ECE3SAT/ECE3SAT_ADCS/PhaseB/Simulator/Simulation/img/Earth.JPG5a55ca7f-1d7c-41d7-b161-80501e00d095Larger.jpg

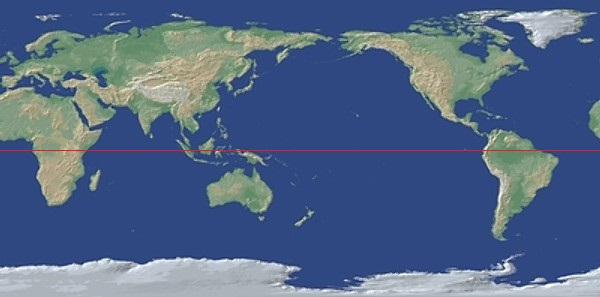
PhaseB/Simulator/Simulation/img/Earth.JPG5a55ca7f-1d7c-41d7-b161-80501e00d095Larger.jpg
