ECE3SAT/ECE3SAT_ADCS/PhaseB/Simulator/Simulation/img/main_900.jpg

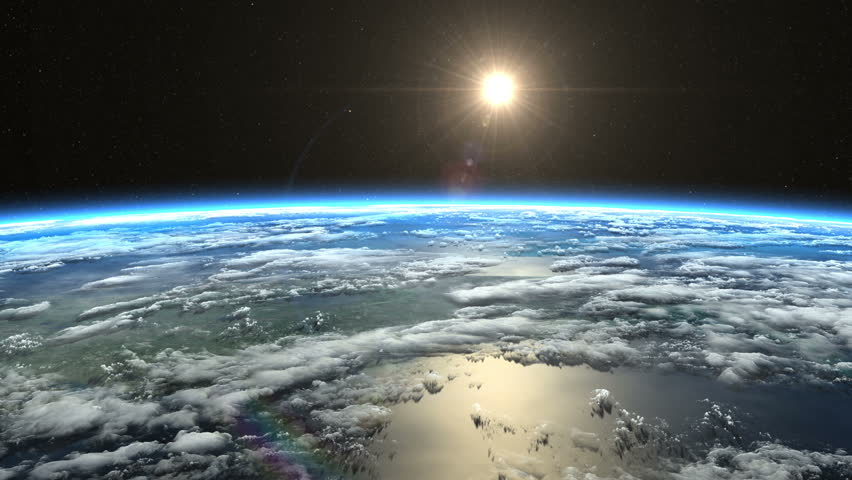
PhaseB/Simulator/Simulation/img/main_900.jpg
