ECE3SAT/ECE3SAT_ADCS/PhaseA/Simulation/SimulationWithBoard/ProcessingCode/Euler/Orientation_Sensors_Reading/solar_panel.png

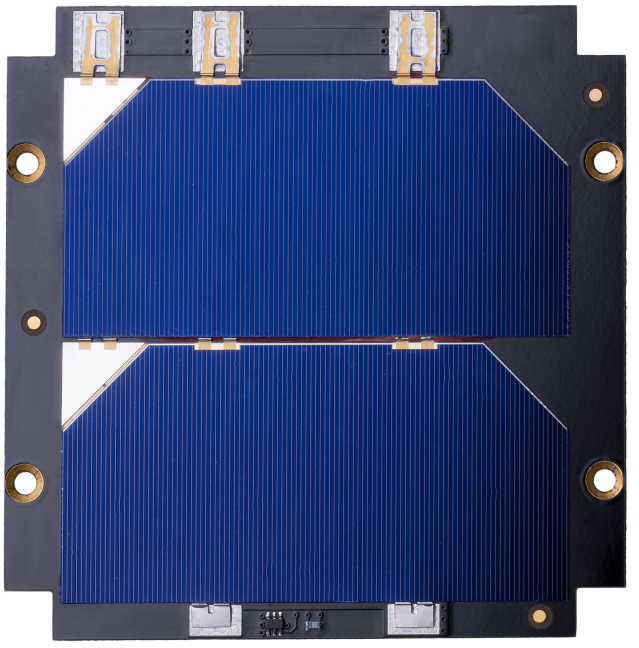
PhaseA/Simulation/SimulationWithBoard/ProcessingCode/Euler/Orientation_Sensors_Reading/solar_panel.png
