ECE3SAT/ECE3SAT_ADCS/PhaseB/Helmholtz coils - CubeSat/Cube/Cube.SLDASM

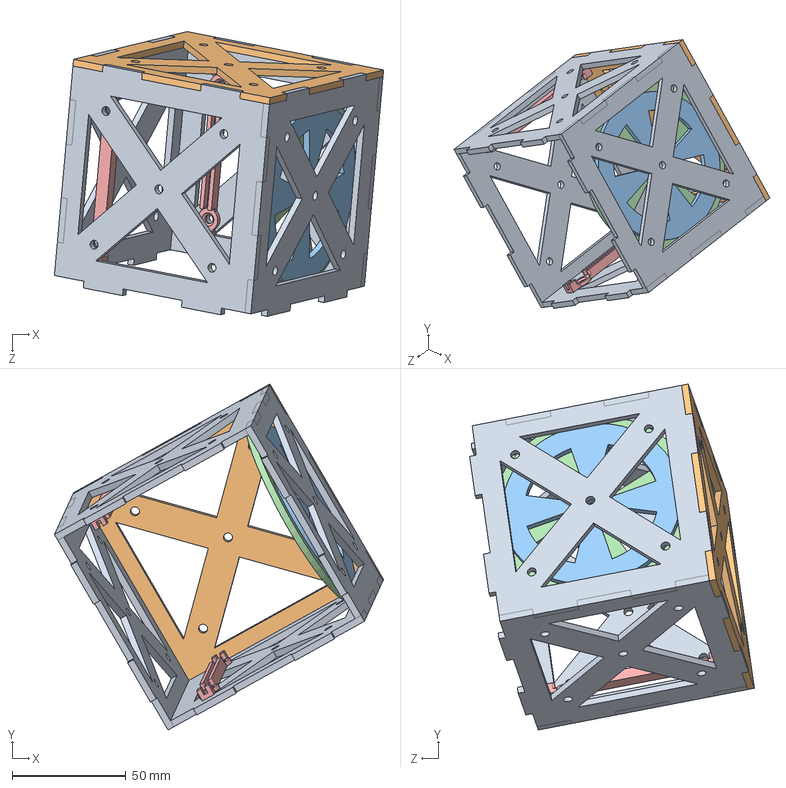
[picture p6: CAD file, 2018-02-19]
PhaseB/Helmholtz coils - CubeSat/Cube/Cube.SLDASM
144.5 x 151.9 x 125.0 mm
CubeSide x 4
wheelXS
wheelS
Rail x 2
