ECE3SAT/ECE3SAT_ADCS/PhaseB/Helmholtz coils - CubeSat/Gyro/Gyro.SLDASM

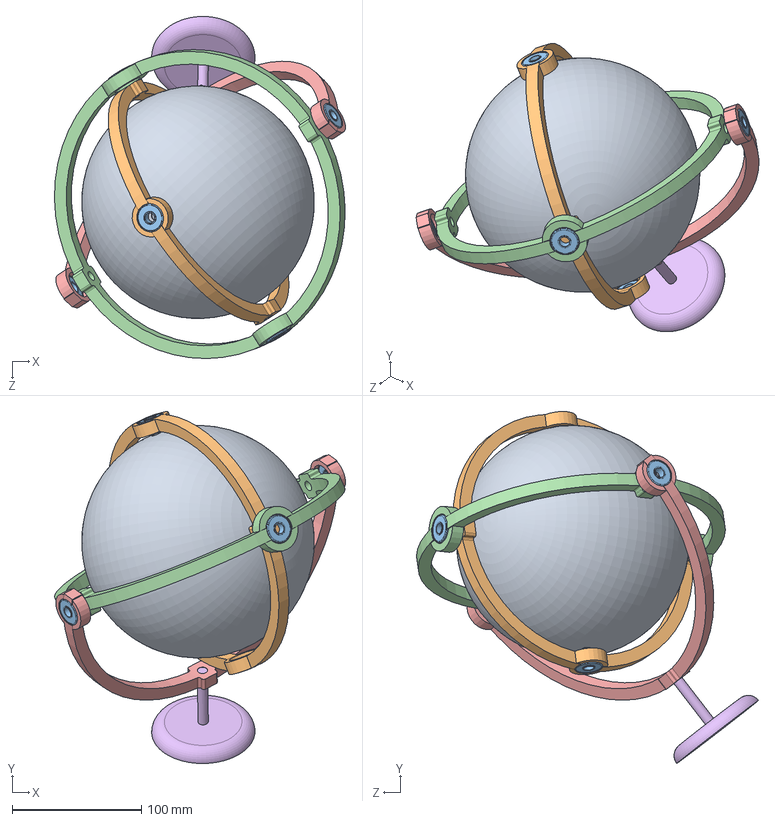
[picture p7: CAD file, 2018-02-19]
PhaseB/Helmholtz coils - CubeSat/Gyro/Gyro.SLDASM
225.3 x 272.4 x 264.8 mm
S1
608ZZ Bearing x 6
S2
S3
Pied
