ECE3SAT/ECE3SAT_ADCS/PhaseB/Helmholtz coils - CubeSat/Clip.SLDPRT

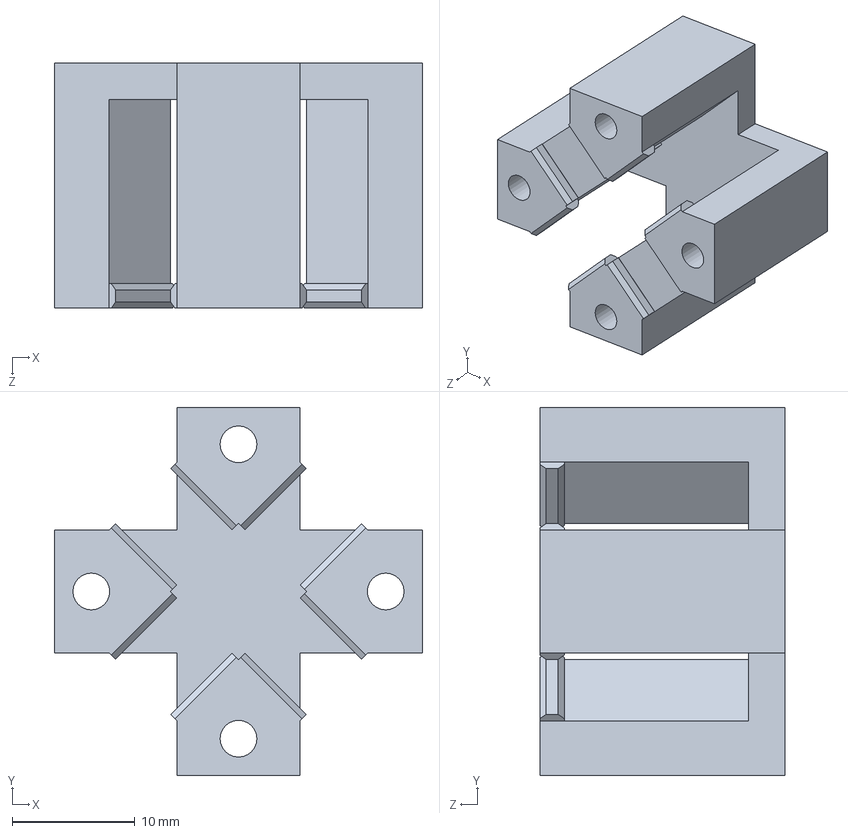
[picture p8: CAD file, 2018-02-19]
PhaseB/Helmholtz coils - CubeSat/Clip.SLDPRT
30.0 x 30.0 x 20.0 mm
