ECE3SAT/ECE3SAT_ADCS/PhaseB/Helmholtz coils - CubeSat/Cube/wheelS.SLDPRT

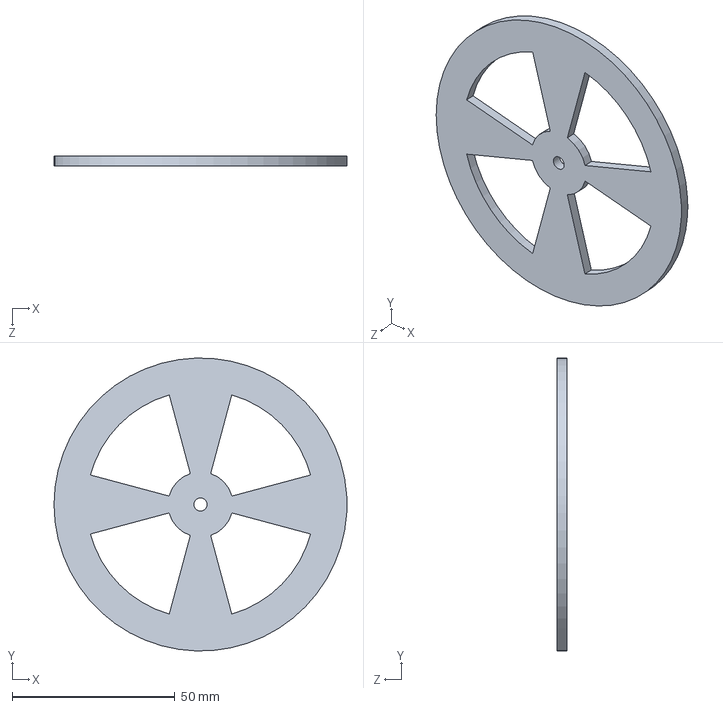
[picture p9: CAD file, 2018-02-19]
PhaseB/Helmholtz coils - CubeSat/Cube/wheelS.SLDPRT
90.0 x 90.0 x 3.00 mm
