ECE3SAT/ECE3SAT_ADCS/PhaseB/Helmholtz coils - CubeSat/Gyro/S2.SLDPRT

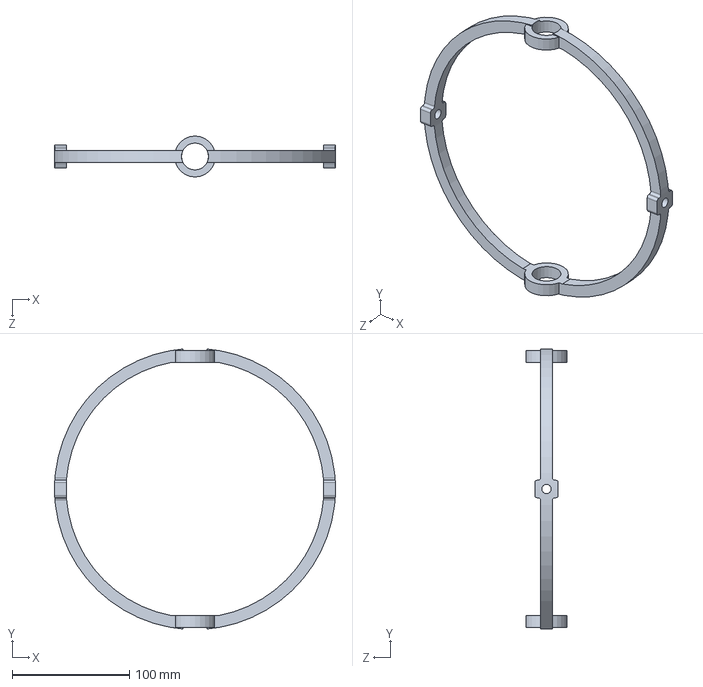
[picture p10: CAD file, 2018-02-19]
PhaseB/Helmholtz coils - CubeSat/Gyro/S2.SLDPRT
240.0 x 239.1 x 35.0 mm
