ECE3SAT/ECE3SAT_ADCS/PhaseB/Helmholtz coils - CubeSat/Gyro/Rondelle.SLDPRT

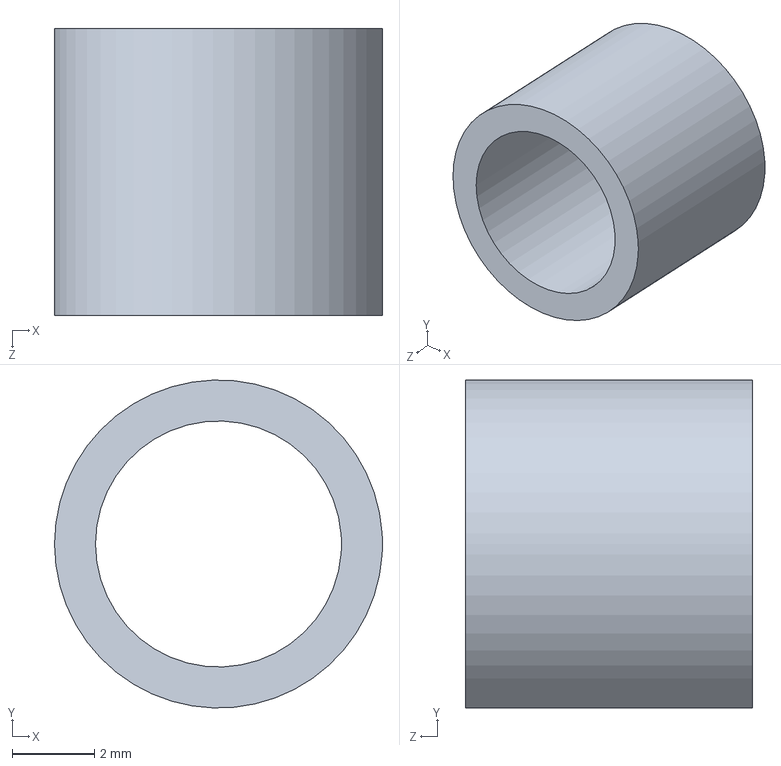
[picture p11: CAD file, 2018-02-19]
PhaseB/Helmholtz coils - CubeSat/Gyro/Rondelle.SLDPRT
8.00 x 8.00 x 7.00 mm
