ECE3SAT/ECE3SAT_ADCS/PhaseB/Helmholtz coils - CubeSat/Cube/wheelXS.SLDPRT

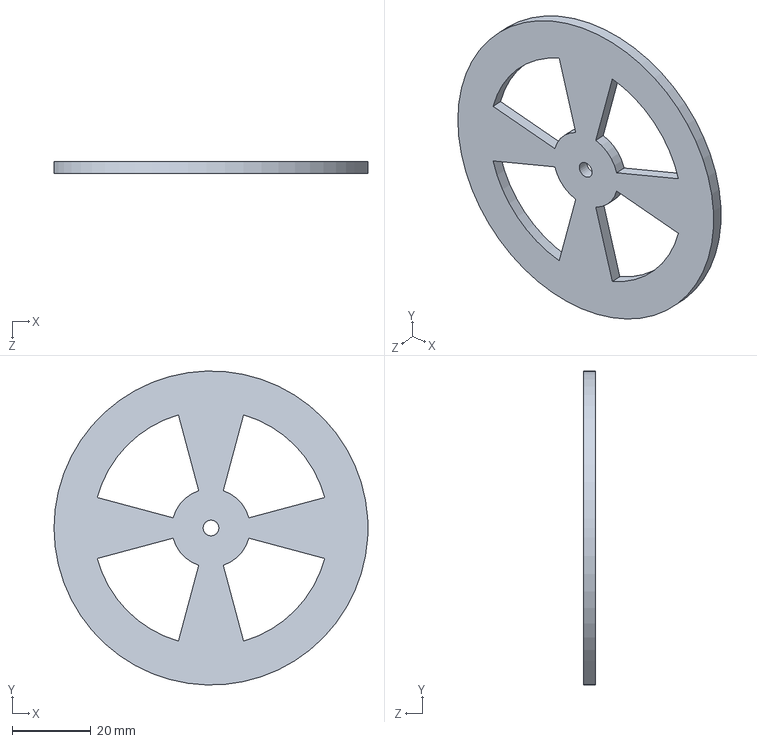
[picture p12: CAD file, 2018-02-19]
PhaseB/Helmholtz coils - CubeSat/Cube/wheelXS.SLDPRT
80.0 x 80.0 x 3.00 mm
