ECE3SAT/ECE3SAT_ADCS/PhaseB/Helmholtz coils - CubeSat/Gyro/Pied.SLDPRT

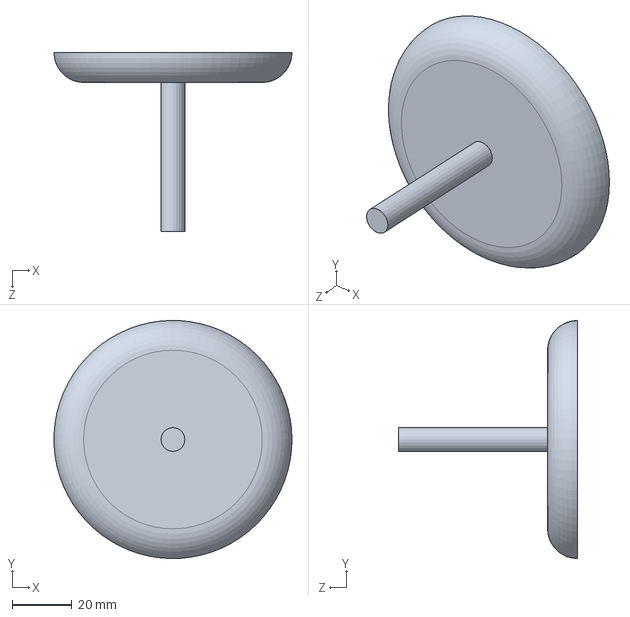
[picture p13: CAD file, 2018-02-19]
PhaseB/Helmholtz coils - CubeSat/Gyro/Pied.SLDPRT
80.0 x 80.0 x 60.0 mm
