ECE3SAT/ECE3SAT_ADCS/PhaseB/Helmholtz coils - CubeSat/Cube/Rail.SLDPRT

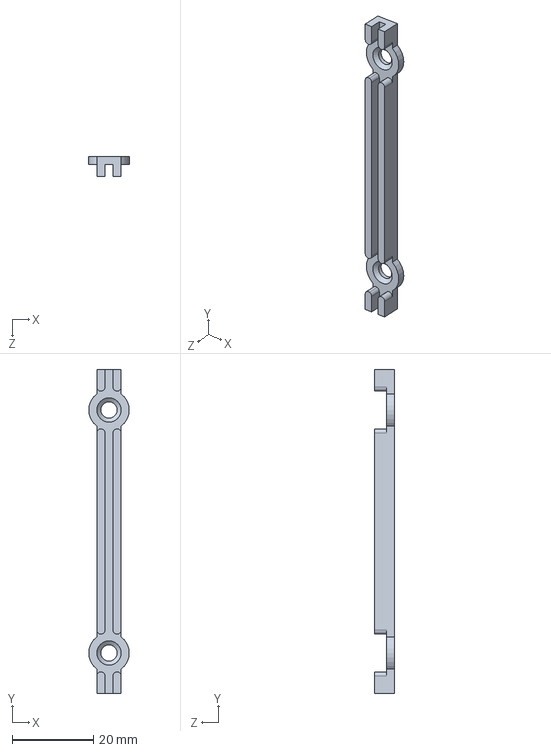
[picture p14: CAD file, 2018-02-19]
PhaseB/Helmholtz coils - CubeSat/Cube/Rail.SLDPRT
10.0 x 80.0 x 5.00 mm
