ECE3SAT/ECE3SAT_ADCS/PhaseB/Helmholtz coils - CubeSat/Gyro/S3.SLDPRT

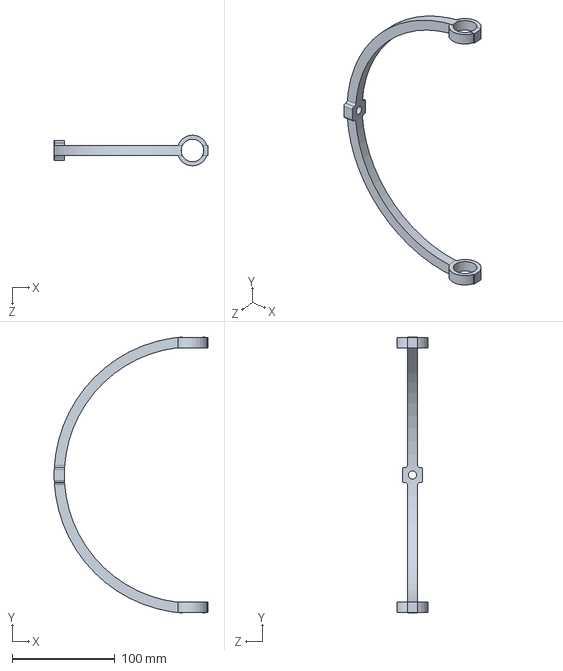
[picture p15: CAD file, 2018-02-19]
PhaseB/Helmholtz coils - CubeSat/Gyro/S3.SLDPRT
150.0 x 269.3 x 30.0 mm
