ECE3SAT/ECE3SAT_ADCS/PhaseB/Helmholtz coils - CubeSat/Cube/CubeSide.SLDPRT

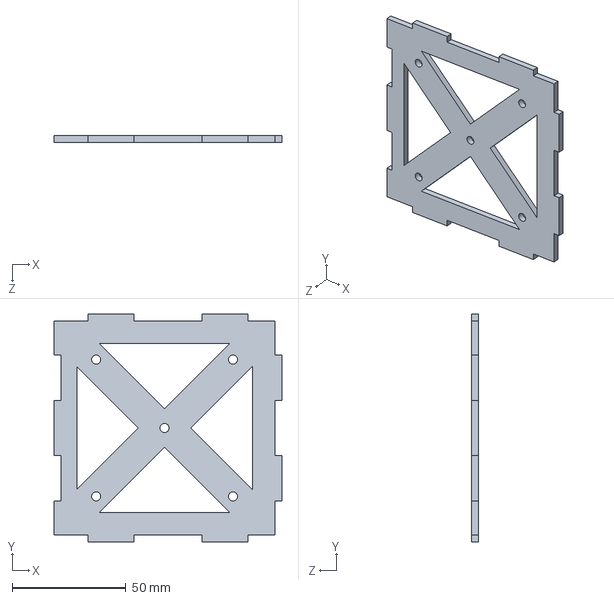
[picture p16: CAD file, 2018-02-19]
PhaseB/Helmholtz coils - CubeSat/Cube/CubeSide.SLDPRT
100.0 x 100.0 x 3.00 mm
