ECE3SAT/ECE3SAT_ADCS/PhaseB/Helmholtz coils - CubeSat/Gyro/Sphere.SLDPRT

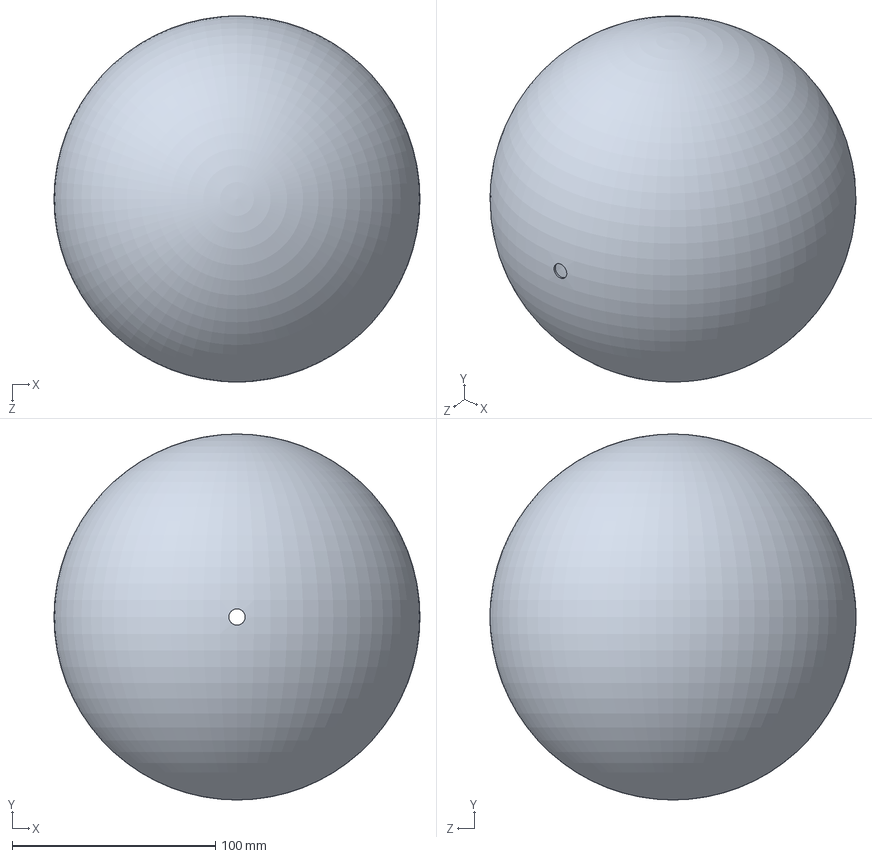
[picture p17: CAD file, 2018-02-19]
PhaseB/Helmholtz coils - CubeSat/Gyro/Sphere.SLDPRT
180.0 x 180.0 x 179.8 mm
