ECE3SAT/ECE3SAT_ADCS/PhaseB/Helmholtz coils - CubeSat/Gyro/608ZZ Bearing.SLDPRT

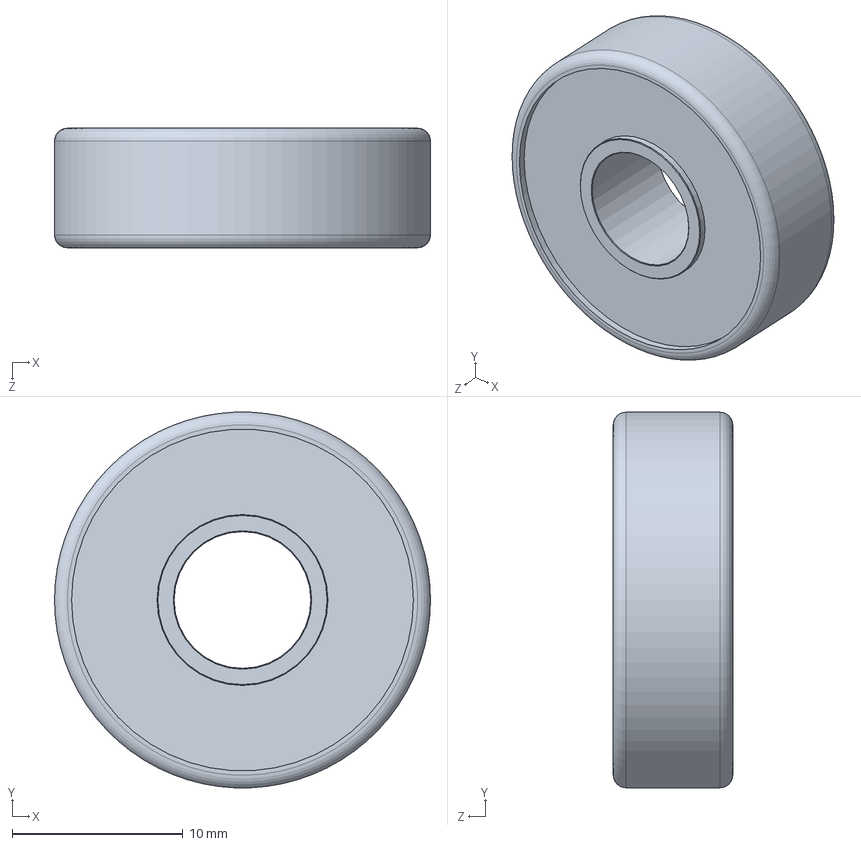
[picture p18: CAD file, 2018-02-19]
PhaseB/Helmholtz coils - CubeSat/Gyro/608ZZ Bearing.SLDPRT
22.0 x 22.0 x 7.00 mm
