ECE3SAT/ECE3SAT_ADCS/PhaseB/Helmholtz coils - CubeSat/Gyro/S1.SLDPRT

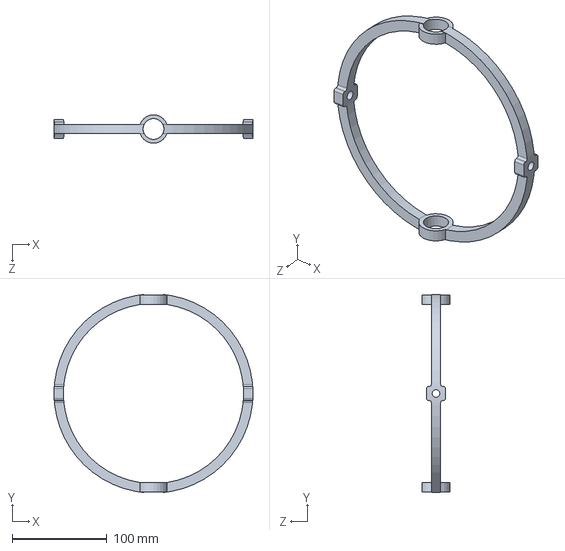
[picture p19: CAD file, 2018-02-19]
PhaseB/Helmholtz coils - CubeSat/Gyro/S1.SLDPRT
210.0 x 209.1 x 30.0 mm
