ECE3SAT/ECE3SAT_ADCS/PhaseB/Helmholtz coils - CubeSat/Gyro/S3_mod.SLDPRT

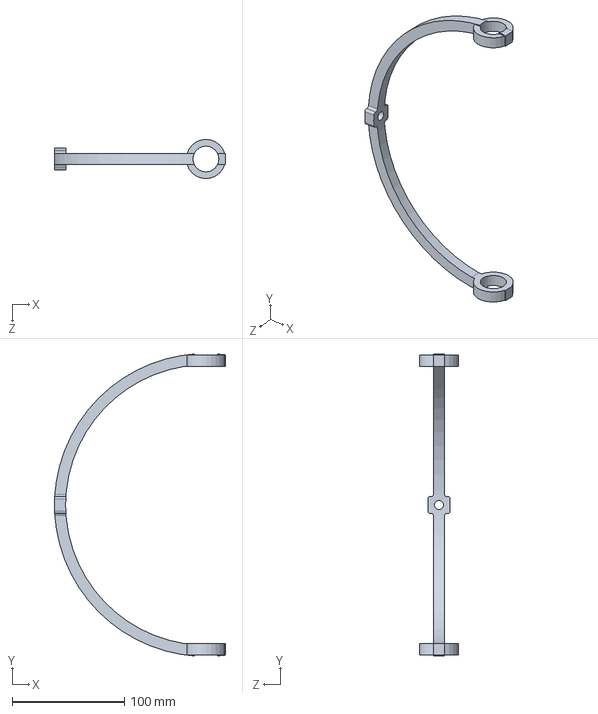
[picture p20: CAD file, 2018-02-19]
PhaseB/Helmholtz coils - CubeSat/Gyro/S3_mod.SLDPRT
152.5 x 269.2 x 35.0 mm
