ECE3SAT/ECE3SAT_ADCS/(list of files, cad)

Other CAD files:
PhaseB/Helmholtz coils - CubeSat/Cube/Cube.DXF
PhaseB/Helmholtz coils - CubeSat/Cube/Cube.SLDPRT
PhaseB/Helmholtz coils - CubeSat/Cube/CubeSide.DXF
PhaseB/Helmholtz coils - CubeSat/Cube/wheelS.DXF
PhaseB/Helmholtz coils - CubeSat/Cube/wheelXS.DXF
