ECE3SAT/ECE3SAT_ADCS/PhaseB/Helmholtz coils - CubeSat/carte_logique/Printing Print.pdf

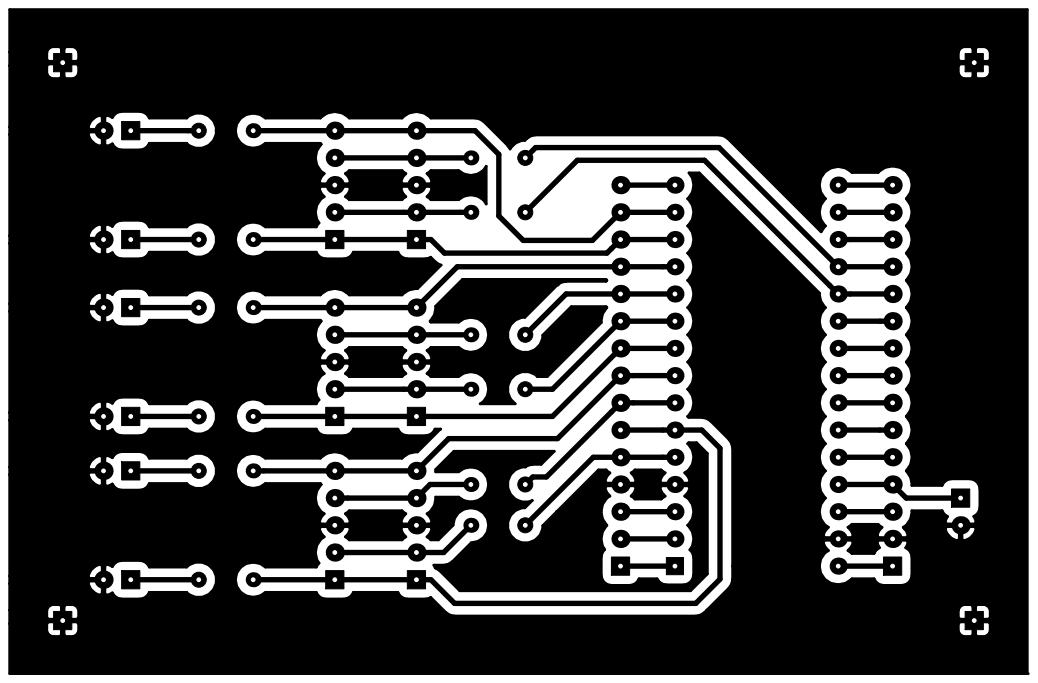
[picture p32: page 1]
