ECE3SAT/ECE3SAT_ADCS/PhaseA/Simulation/SimulationWithPID/PID_Processing/ProcPID.pde

class Test_PID {
  ////////////Edital parts///////////
  float commandMultiplier = .3;
  float disp=0.2;
  float KP=1;
  float KI=0;
  float KD=0;
  ///////////////////////
  float currentValue, prevValue;  
  float pidVal;
  Pid pid;
  float measure;


  //Constructor
  Test_PID() {
    measure=currentValue;
    pidVal=0;
    pid=new Pid(KP, KI, KD, measure);
    pid.consigne=20.;
  }


  // Simulate the varation of the measure. 
  public float systemSimulator(float command) {
    measure=command*commandMultiplier +currentValue;
    measure=measure+disp*pid.varSens;
    prevValue = currentValue;
    currentValue=measure;
    return measure;
  }


  public float myEvaluation(int consignFrom, float Measure) {
    currentValue=degrees(Measure);
    pid.consigne= consignFrom; 
    Measure= degrees(Measure);
    pidVal=pid.calculatePID(Measure);
    measure=systemSimulator(pidVal);
    return measure;
  }
  
  public float offPID(){
    measure=measure+disp*pid.varSens;
    return measure;
  }
    
}
