ECE3SAT/ECE3SAT_ADCS/(commit log)

2018-02-06 PhaseB update
    Simulator code added with the arduino code to test the BDOT
2018-02-06 Python reading of serial
    Trace the magnetorquers graph read from the serial port
2018-02-19 Helmoltz + CubeSat ressources added
    All the code and models of the CubeSats and helmoltz environment are added
    [608ZZ Bearing.SLDPRT, Clip.SLDPRT, Cube.DXF, Cube.SLDASM, Cube.SLDPRT, CubeSide.DXF, CubeSide.SLDPRT, Gyro.SLDASM]
